kolganovr/KursachKonstruirovanie/Печать/А4 Перечень компонентов.pdf

| | № докум. | Подп. | Дата | МВАУ.405113.008 ПЭ3 Изм. Лист
| | Разраб. | Колганов | | | Датчик температуры | Лит. | Лист | Листов
Пров. | Исаев | | | | | | | 1 4
Н.контр. Инв. № подл. Подп. и дата Взам. инв. № Инв. № дубл. Подп. и дата | Утв. | Исаев Справ. № Перв. примен. МВАУ.40⁵¹¹³.008 | Датчик температуры
BK1 | TO-92 DS18B20 | 1
| Конденсаторы
С1 | ECAP 10x12мм 400В ±20% 1мкФ | 1
С2 | RADIAL-2 9,7х8,3мм 25В ±20% 470мкФ | 1
С3, С4 | 1608 5В ±10% 22мкФ | 2
С5 | 1608 16В ±10% 1мкФ | 1
С6 | RADIAL-2 10,3х11,7мм 16В ±20% 1000мкФ | 1
С7 | 1608 5В ±10% 0,1мкФ | 1

Стабилизатор напряжения

DA1 | SOT-89 78L05 | 1
| Микросхема
DD1 | SOIC-18 PIC16F84A | 1
| Предохранитель плавкий
FU1 | MELF ВП2Т-1Ш 0,25А 250В | 1

Поз.
обозначение
Наименование | Кол. | Примечание
Копировал | Формат A4

## МВАУ.405113.008 ПЭ3 Лист

Излучатель звука электромагнитный

HA1 | KCG0603-K 6,6мм 2-5В 3кГц | 1
| Дисплеи 7-сегментные
HG1..HG3LSD3C52-20 0,32'' 565нм | 3
| Резисторы
R1 | 0805 0,125Вт 20 кОм ±5% | 1
R2 | 0805 0,125Вт 100 Ом ±5% | 1
R3 | 0805 0,125Вт 300 Ом ±5% | 1
R4, R6 | 0805 0,125Вт 2 кОм ±5% | 2
R5 | 0805 0,125Вт 4,7 кОм ±5% | 1
R7 | 0805 0,125Вт 470 Ом ±5% | 1
R8..R14 0805 0,125Вт 200 Ом ±5% | | 7

Кнопки

SB1, SB2 800AWSP9M2QE | | 2
Изм. Лист | № докум. Подп. Дата | | 2 Инв. № подл. Подп. и дата Взам. инв. № Инв. № дубл. Подп. и дата

Диоды

VD1 | КЦ407А 400В 500мА | 1
VD2 | SMB Стабилитрон 15В 3вт ±5% | 1
VD3 | SMA Диод 50в 1А | 1

МВАУ.405113.008 ПЭ3 | Лист
3 Инв. № подл. Подп. и дата Взам. инв. № Инв. № дубл. Подп. и дата | Изм. Лист | № докум. | Подп. | Дата

Транзистор

VT1 | КТ315Б NPN 20В 0,1А 0,15Вт | 1
| Разъем
XS1 | TE_282837-2 5,08мм | 1
| Резонатор кварцевый
Z1 | HC-49SM 4МГц 32пФ | 1

| | № докум. | Подп. | Дата | МВАУ.405113.008 ПЭ3 Изм. Лист
| | Разраб. | Колганов | | | Датчик температуры | Лит. | Лист | Листов
Пров. | Исаев | | | | | | | 4 4
Н.контр. Инв. № подл. Подп. и дата Взам. инв. № Инв. № дубл. Подп. и дата | Утв. | Исаев Справ. № Перв. примен.
| | Лист регистрации изменений
Изм. | Номера листов (страниц) | Всего листов (страниц) в доку-менте | Номер документа | Входящий номер сопроводи-тельного документа и дата | Подпись | Дата
изме-нен-ных | заме-нен-ных | новых анну- | лиро-ван-ных
