kolganovr/KursachKonstruirovanie/Печать/А4 Спецификация платы.pdf

| | № докум. | Подп. | Дата | МВАУ.405113.008 Изм. Лист
| | Разраб. | Колганов | | | Датчик температуры | Лит. | Лист | Листов
Пров. | Исаев | | | | | | | 1 4
Н.контр. Инв. № подл. Подп. и дата Взам. инв. № Инв. № дубл. Подп. и дата | Утв. | Исаев Справ. № Перв. примен. МВАУ.40⁵¹¹³.007 | Документация
А4 | | МВАУ.405113.008 СБ | Сборочный чертёж
А3 | | МВАУ.405113.008 Э3 | Схема электрическая
| | | принципиальная
А4 | | МВАУ.405113.008 ПЭ3 | Перечень элементов
| Поз. 5 | Обозначение | SMA Диод 50в 1А Наименование | Кол. 1 | VD3 Формат Зона Приме-

Детали

1 | МВАУ.758724.007 | Плата печатная | 1
| | Прочие изделия

Датчик температуры

2 | TO-92 DS18B20 | 1 | BK1
| Диоды
3 | КЦ407А 400В 500мА | 1 | VD1
4 | SMB Стабилитрон | 1 | VD2
| 15В 3вт ±5%

чание

Копировал | Формат A4

## МВАУ.405113.008 Лист

Дисплеи 7-сегментные

6 | LSD3C52-20 0,32'' 565нм | 3 | HG1..HG3

Излучатель звука
электромагнитный
7 | KCG0603-K 6,6мм 2-5В 3кГц | 1 | HA1
| Кнопки
8 | 800AWSP9M2QE | 2 | SB1, SB2
| Конденсаторы
| 9 | | ECAP 10x12мм | 1 | С1
| | | 400В ±20% 1мкФ
| 10 | | RADIAL-2 9,7х8,3мм | 1 | С2
| | | 25В ±20% 470мкФ
| 11 | | 1608 5В ±10% 22мкФ | 2 | С3, С4
| 12 | | 1608 16В ±10% 1мкФ | 1 | С5
Изм. Лист | 13 | № докум. Подп. Дата | RADIAL-2 10,3х11,7мм | 1 | 2 Инв. № подл. Подп. и дата Взам. инв. № Инв. № дубл. Подп. и дата С6
| | | 16В ±20% 1000мкФ
| 14 | | 1608 5В ±10% 0,1мкФ | 1 | С7

Микросхема

15 | SOIC-18 PIC16F84A | 1 | DD1 Формат Зона | Поз. | Обозначение | Наименование | Кол. | Приме-

МВАУ.405113.008 | Лист
3 Инв. № подл. Подп. и дата Взам. инв. № Инв. № дубл. Подп. и дата | Изм. Лист | № докум. | Подп. | Дата

Предохранитель плавкий

16 | MELF ВП2Т-1Ш | 1 | FU1
| 0,25А 250В

Разъём

17 | TE_282837-2 5,08мм | 1 | XS1
| Резисторы
18 | 0805 0,125Вт 20 кОм ±5% | 1 | R1
19 | 0805 0,125Вт 100 Ом ±5% | 1 | R2
20 | 0805 0,125Вт 300 Ом ±5% | 1 | R3
21 | 0805 0,125Вт 2 кОм ±5% | 2 | R4, R6
22 | 0805 0,125Вт 4,7 кОм ±5% | 1 | R5
23 | 0805 0,125Вт 470 Ом ±5% | 1 | R7
24 | 0805 0,125Вт 200 Ом ±5% | 7 | R8..R14

Резонатор кварцевый

25 | HC-49SM 4МГц 32пФ | 1 | Z1
| Стабилизатор напряжения
26 | SOT-89 78L05 | 1 | DA1
| Транзистор
27 | КТ315Б NPN 20В 0,1А 0,15Вт | 1 | VT1 Формат Зона | Поз. | Обозначение | Наименование | Кол. | Приме-

| | № докум. | Подп. | Дата | МВАУ.405113.008 Изм. Лист
| | Разраб. | Колганов | | | Датчик температуры | Лит. | Лист | Листов
Пров. | Исаев | | | | | | | 4 4
Н.контр. Инв. № подл. Подп. и дата Взам. инв. № Инв. № дубл. Подп. и дата | Утв. | Исаев Справ. № Перв. примен.
| | Лист регистрации изменений
Изм. | Номера листов (страниц) | Всего листов (страниц) в доку-менте | Номер документа | Входящий номер сопроводи-тельного документа и дата | Подпись | Дата
изме-нен-ных | заме-нен-ных | новых анну- | лиро-ван-ных
