kolganovr/KursachKonstruirovanie/Печать/А4 Спецификация устройства.pdf

| | № докум. | Подп. | Дата | МВАУ.405113.007 Изм. Лист
| | Разраб. | Колганов | | | Датчик температуры | Лит. | Лист | Листов
Пров. | Исаев | | | | | | | | 1
Н.контр. Инв. № подл. Подп. и дата Взам. инв. № Инв. № дубл. Подп. и дата | Утв. | Исаев Справ. № Перв. примен. | Документация
А3 | | МВАУ.405113.007 СБ | Сборочный чертеж
| | | Сборочные единицы
А4 | 1 | МВАУ.405113.008 | Печатный узел | 1
| | | Детали
А4 | 2 | МВАУ.731121.007 | Корпус | 1
А4 | 3 | МВАУ.731151.007 | Крышка | 1

Стандартные изделия

4 | Винт А.М2,5-6gx11 | 4
| ГОСТ 17473-80
5 | Винт А.М2,5-6gx6 | 4
ГОСТ 17473-80 Формат Зона | Поз. | Обозначение | Наименование | Кол. | Приме-
чание
Копировал | Формат A4
