kolganovr/KursachKonstruirovanie/Печать/Титульник.pdf

Москва 2023 г.

Федеральное государственное бюджетное образовательное

учреждение высшего образования

МОСКОВСКИЙ АВИАЦИОННЫЙ ИНСТИТУТ

(Национальный исследовательский университет)

Институт №3 «Системы управления, информатика и электроэнергетика»

Кафедра №307 «Цифровые технологии и информационные системы»

ОТЧЕТ

О выполнении курсовой работы по дисциплине

«Конструирование СИВТ»

Выполнил студент

группы М3О-214Б-21

Подпись:

Колганов Роман

Андреевич

Принял

Ст. преподаватель

Подпись:

Исаев Владимир

Владимирович
