kolganovr/KursachKonstruirovanie/Модель платы/PCB1.step

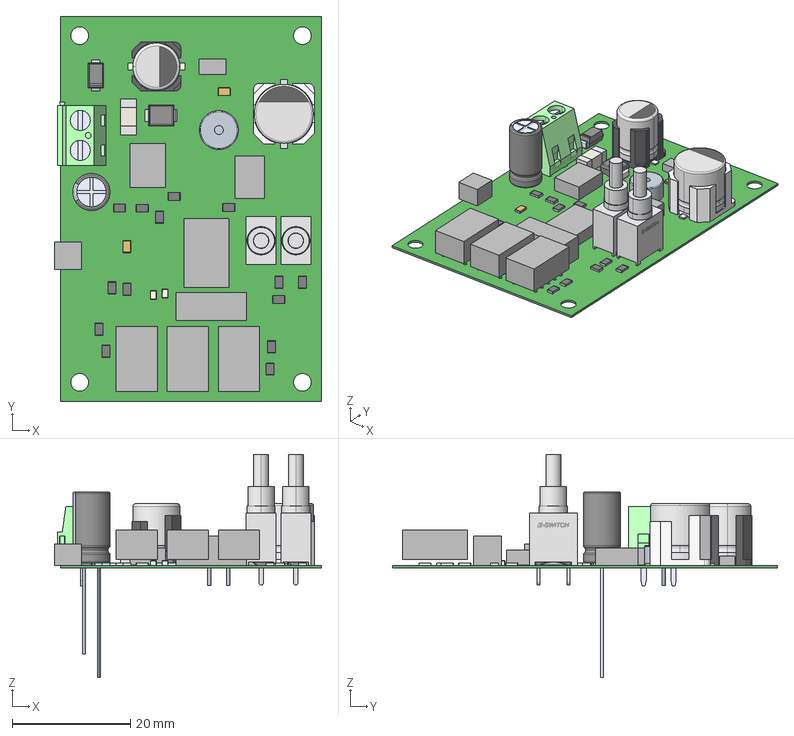
[picture p1: CAD file, 2023-06-10]
Модель платы/PCB1.step
45.3 x 65.2 x 37.8 mm
Extruded x 12
US1A-13-F
SZ1SMB5929BT3G
TACL226M005RTA x 2
UVY2G010MED1TD
Mid Body x 14
Mark x 14
