kolganovr/KursachKonstruirovanie/Печать/А3 Карта отверстий.pdf

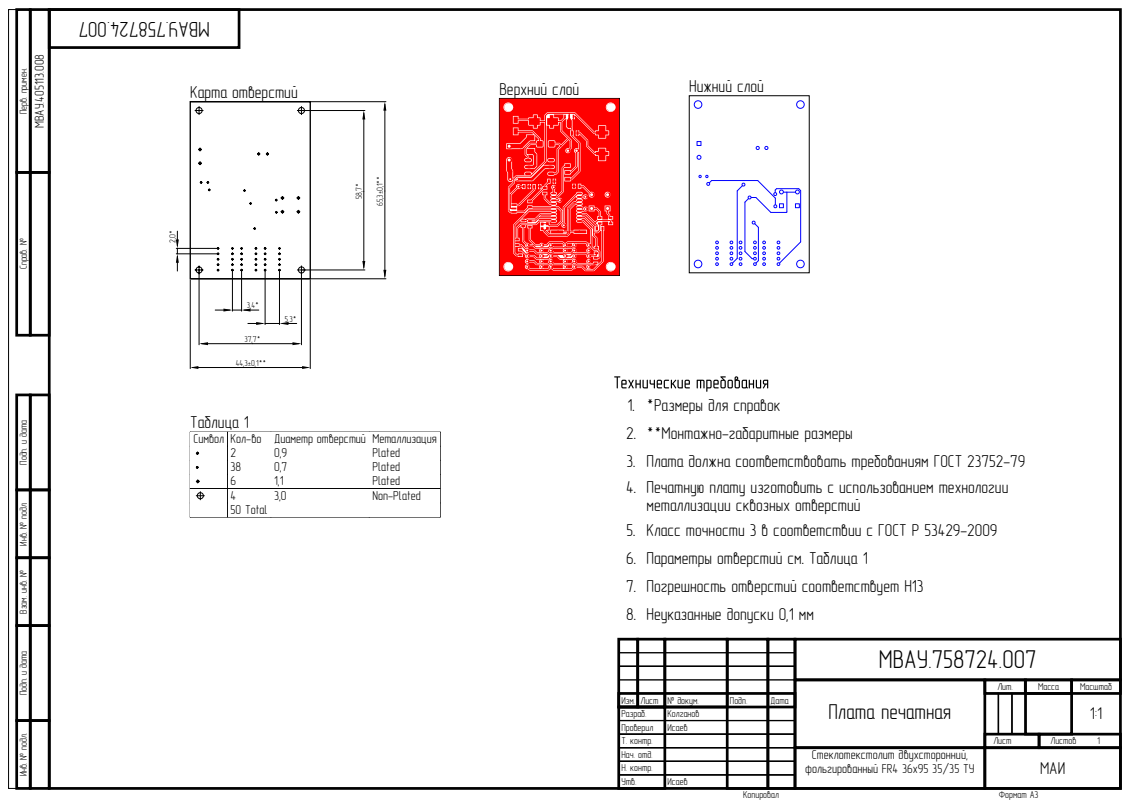
[picture p2: page 1]
Карта отверстий; Верхний слой; Нижний слой; Таблица 1; Изм. Лист № докум. Разраб.; Подп.; Дата; Проверил Т. контр.; Н. контр. Утв.; Лит.; Масса; Масштаб; Лист; Листов; Плата печатная; МВАУ.758724.007; Колганов; Исаев; Копировал; Формат А3; МАИ; Нач. отд.; МВАУ.405113.008; Стеклотекстолит двухсторонний, фольгированный FR4 36x95 35/35 ТУ

Перв. примен. Справ. № Подп. и дата Инв. № подл. Взам. инв. № Подп. и дата Инв. № подл.

1. *Размеры для справок
2. **Монтажно-габаритные размеры
3. Плата должна соответствовать требованиям ГОСТ 23752-79
Печатную плату изготовить с использованием технологии
металлизации сквозных отверстий
5. Класс точности 3 в соответствии с ГОСТ Р 53429-2009
6. Параметры отверстий см. Таблица 1
7. Погрешность отверстий соответствует H13
8. Неуказанные допуски 0,1 мм

Символ | Кол-во | Диаметр отверстий | Металлизация
2 | 0,9 | Plated
38 | 0,7 | Plated
6 | 1,1 | Plated
4 | 3,0 | Non-Plated
50 Total
