kolganovr/KursachKonstruirovanie/Печать/А4 Чертеж Корпус.pdf

А

R4

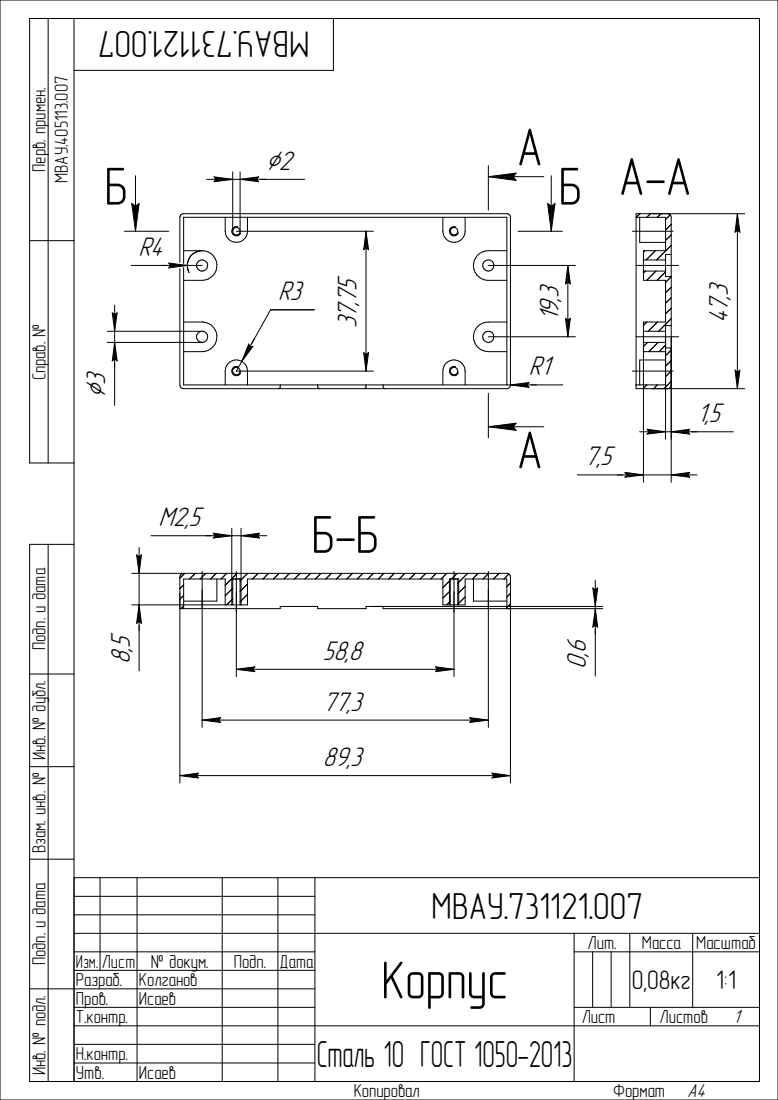
[picture p3: page 1]
Исаев; Сталь 10 ГОСТ 1050-2013 Инв. № подл. Подп. и дата Взам. инв. № Инв. № дубл. Подп. и дата Справ. № Перв. примен.; МВАУ.40⁵¹¹³.007; Копировал; Формат A4

МВАУ.731121.007

Корпус | Лит. | Масса | Масштаб

Изм. Лист | № докум. | Подп. | Дата | | | | | 0,08кг | 1:1
Разраб. | Колганов
Пров. | Исаев
Т.контр. | | | | Лист | Листов 1
Н.контр.
Утв.
