kolganovr/KursachKonstruirovanie/Печать/А4 Чертеж Крышка.pdf

11

R4 | 1,67

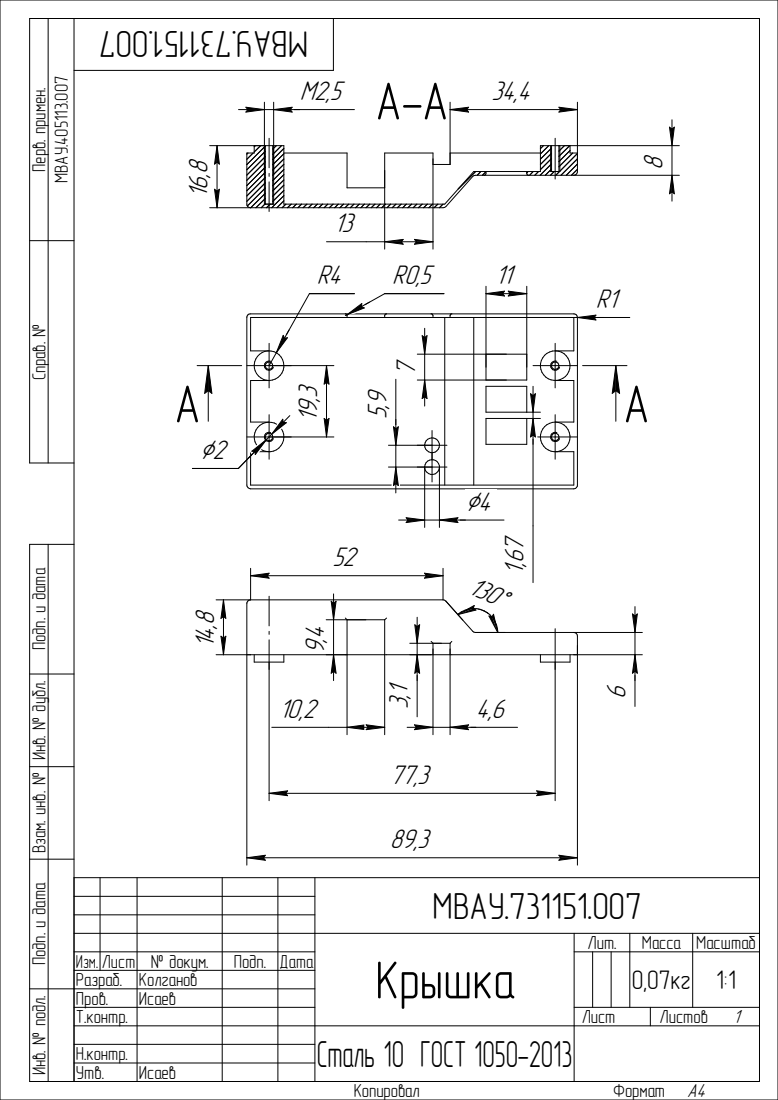
[picture p4: page 1]
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

МВАУ.731151.007

Крышка | Лит. | Масса | Масштаб

Изм. Лист | № докум. | Подп. | Дата | | | | | 0,07кг | 1:1
Разраб. | Колганов
Пров. | Исаев
Т.контр. | | | | Лист | Листов 1
Н.контр.
Утв.
