kolganovr/KursachKonstruirovanie/Печать/А3 Принципиальная схема.pdf

*ST

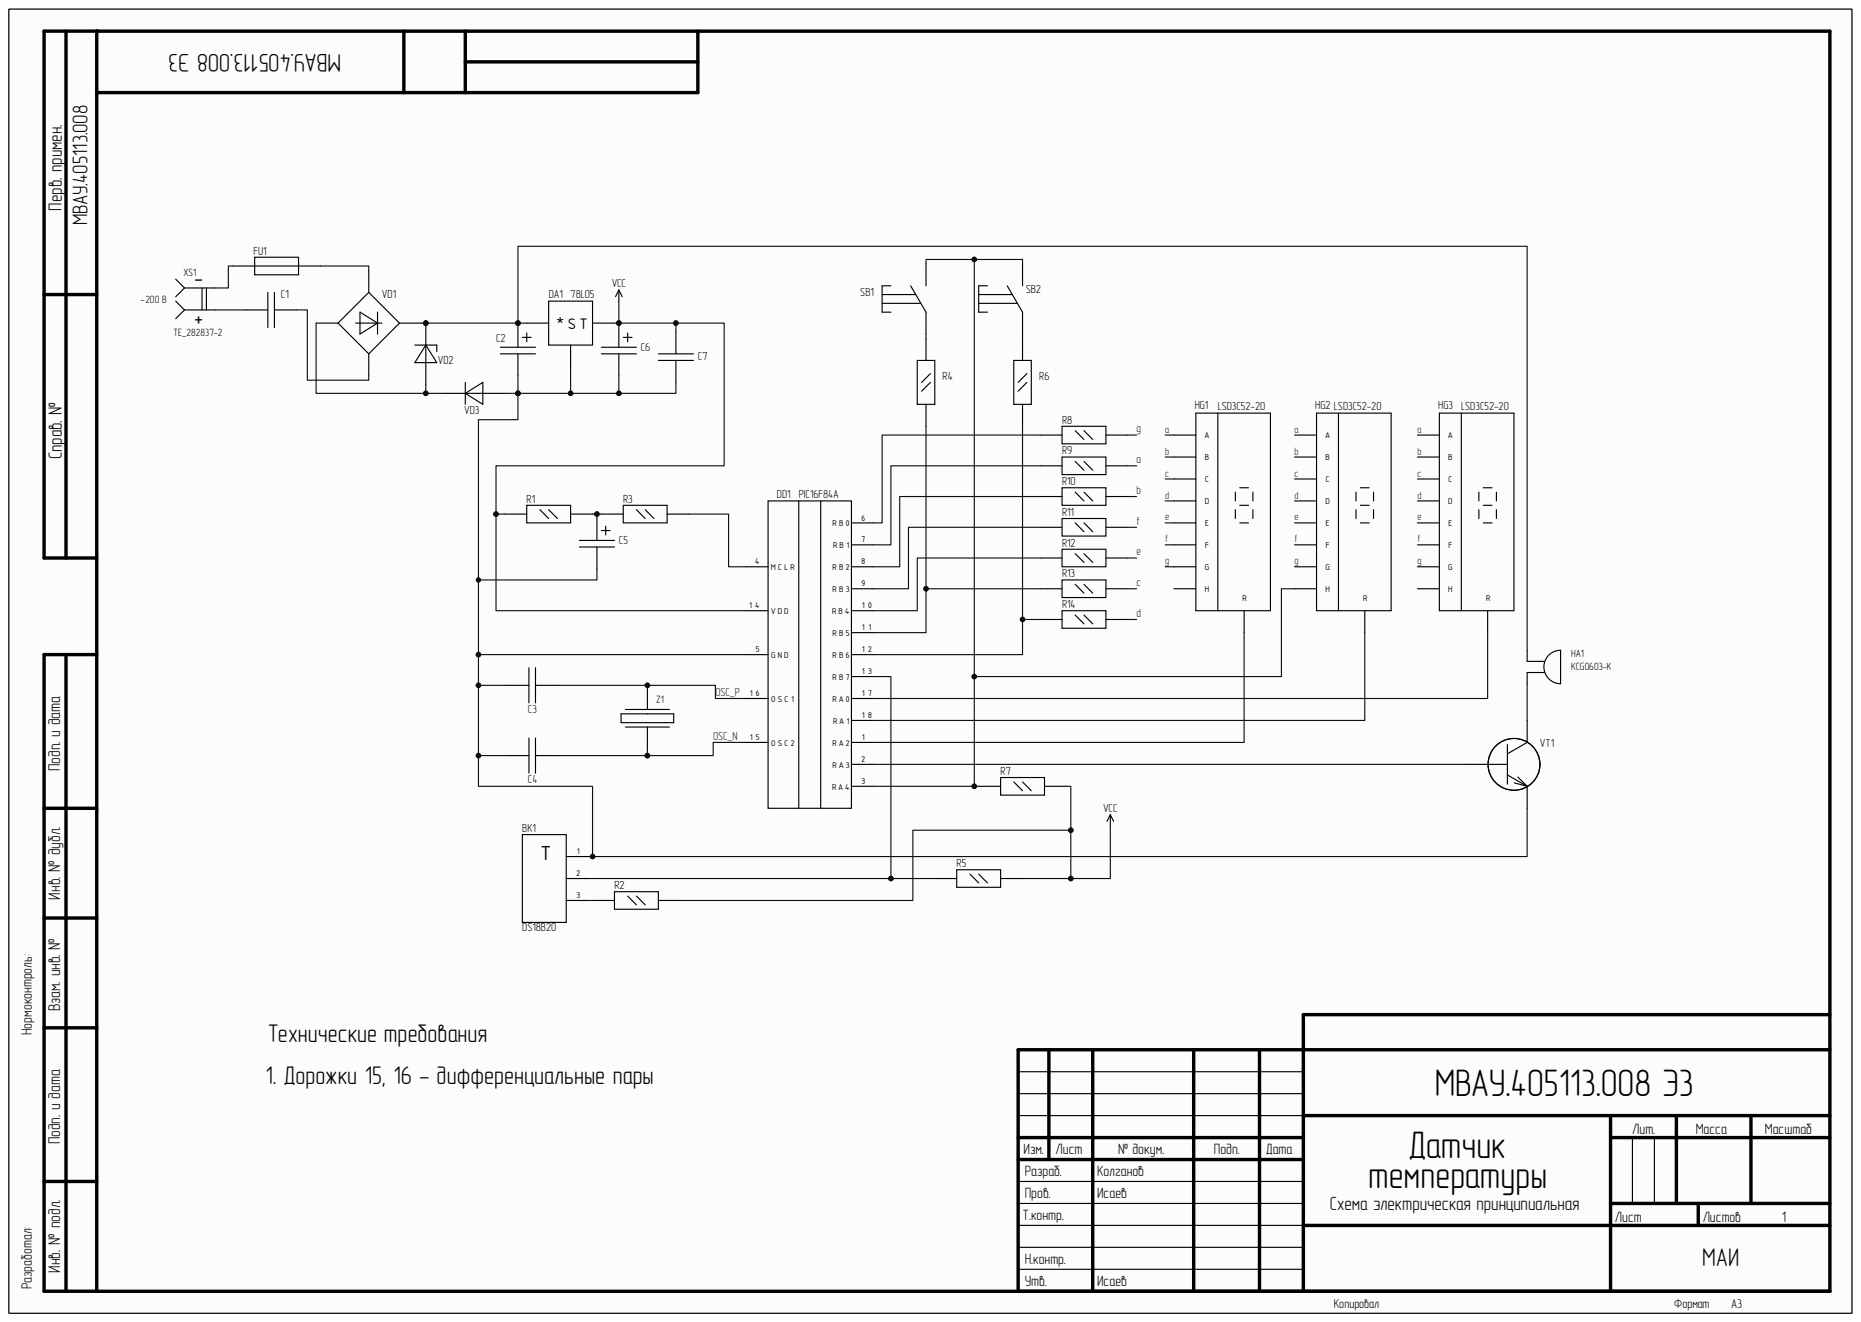
[picture p5: page 1]

МВАУ.405113.008 Э3

Датчик температуры Схема электрическая принципиальная | Лит. | Масса | Масштаб

Изм. | Лист | № докум. | Подп. | Дата
Разраб. | | Колганов
Пров. | | Исаев
Т.контр. | | | | | Лист | Листов 1

МАИ

Н.контр.
Утв. | Исаев
