kolganovr/KursachKonstruirovanie/Печать/А3 Чертеж Устройства.pdf

Б

А

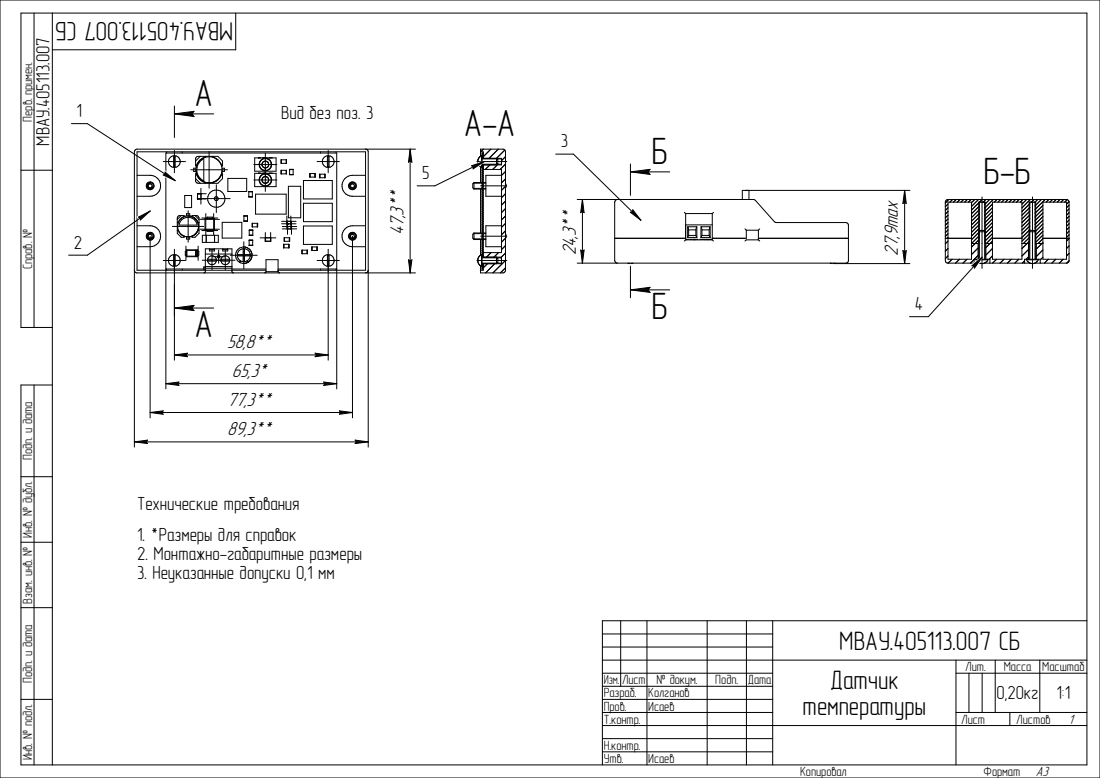
[picture p6: page 1]
27,9max; 0,20кг Датчик; Исаев Инв. № подл. Подп. и дата Взам. инв. № Инв. № дубл. Подп. и дата; Исаев Справ. № Перв. примен. МВАУ.40⁵¹¹³.007; Копировал; Формат A3

Вид без поз. 3

Технические требования
1. *Размеры для справок
2. Монтажно-габаритные размеры
3. Неуказанные допуски 0,1 мм

МВАУ.405113.007 СБ

температуры | Лит. | Масса | Масштаб

Изм. Лист | № докум. | Подп. | Дата | | | | | 1:1
Разраб. | Колганов
Пров.
Т.контр. | | | | Лист | Листов 1
Н.контр.
Утв.
