kolganovr/KursachKonstruirovanie/Печать/А4 Плата СБ.pdf

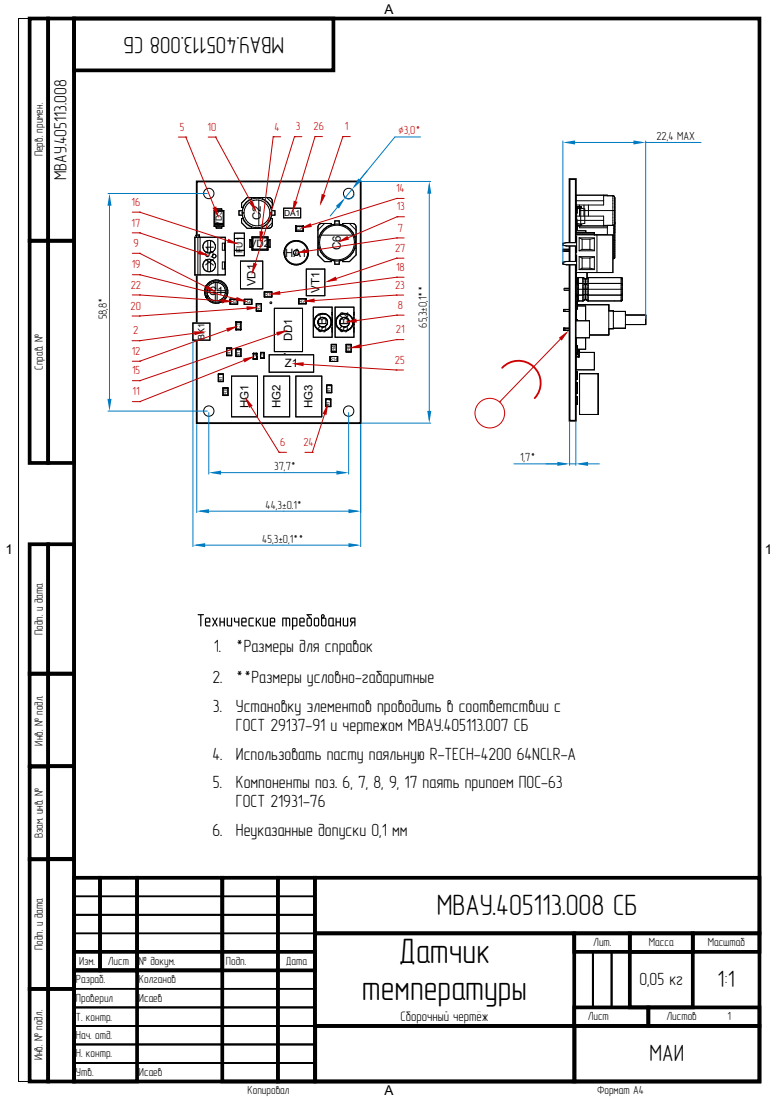
[picture p7: page 1]

Перв. примен. Справ. № Подп. и дата Инв. № подл. Взам. инв. № Подп. и дата Инв. № подл.

1. *Размеры для справок
2. **Размеры условно-габаритные
Установку элементов проводить в соответствии с
ГОСТ 29137-91 и чертежом МВАУ.405113.007 СБ
4. Использовать пасту паяльную R-TECH-4200 64NCLR-A
Компоненты поз. 6, 7, 8, 9, 17 паять припоем ПОС-63
ГОСТ 21931-76
6. Неуказанные допуски 0,1 мм
