kolganovr/KursachKonstruirovanie/(list of files, drawings)

Other design files:
PCB1.PcbDoc
PCB_Project_2.PrjPcb
PcbLib_RomanK.PcbLib
RomanK1.SchDoc
RomanK.SchDoc
RomanK.SchLib
