kolganovr/KursachKonstruirovanie/(commit log)

2023-05-26 public repositorium
    [PCB_Project_2.PrjPcb, PcbLib_RomanK.PcbLib, RomanK.SchDoc, RomanK.SchLib, RomanK1.SchDoc]
2023-05-28 Add КД243А
    [PcbLib_RomanK.PcbLib]
2023-05-28 Add КЦ407А
    +rename PIC 16
    [PcbLib_RomanK.PcbLib]
2023-05-28 Button 2 pin
    [PcbLib_RomanK.PcbLib]
2023-05-28 КТ315Б
    [PcbLib_RomanK.PcbLib]
2023-05-28 ds18b20 (Temp)
    [PcbLib_RomanK.PcbLib]
2023-05-28 ВП2Т-1Ш (плавкий предохранитель)
    [PcbLib_RomanK.PcbLib]
2023-05-28 lsd3212-20 (7 segment display)
    [PcbLib_RomanK.PcbLib]
2023-05-28 HC0903A (Пищалка)
    [PcbLib_RomanK.PcbLib]
2023-05-29 Screw terminal
    not sure
    [PcbLib_RomanK.PcbLib]
2023-05-29 add footprints (not all) and create pcb
    [PCB1.PcbDoc, RomanK.SchLib]
2023-05-29 update font in schematics
    +fix PIC footprint on led
    [RomanK.SchLib]
2023-05-29 res scheme fix
    [RomanK.SchLib]
2023-05-29 add polar capasitor
    [PcbLib_RomanK.PcbLib]
2023-05-29 add footprints of capasitors to Sch Lib
    [RomanK.SchLib]
2023-05-29 Много чего-то
    [PCB1.PcbDoc, PcbLib_RomanK.PcbLib, RomanK.SchLib, RomanK1.SchDoc]
2023-05-29 Fuse box
    [RomanK.SchLib]
2023-05-30 update designators
    new lsd
    [PCB1.PcbDoc, PCB_Project_2.PrjPcb, PcbLib_RomanK.PcbLib, RomanK.SchLib, RomanK1.SchDoc]
2023-05-30 3x lsd some tweaks
    [PCB1.PcbDoc, PcbLib_RomanK.PcbLib, RomanK.SchLib, RomanK1.SchDoc]
2023-06-01 update schdoc
    [PCB1.PcbDoc, RomanK1.SchDoc]
2023-06-01 fix board issue. Start making board
    [PcbLib_RomanK.PcbLib, RomanK.SchLib, RomanK1.SchDoc]
2023-06-01 before 2 layers
    [PCB1.PcbDoc]
2023-06-01 no poligon
    [PCB1.PcbDoc]
2023-06-02 final pcb (i guess)
    [PCB1.PcbDoc, PcbLib_RomanK.PcbLib, RomanK1.SchDoc]
2023-06-04 new elemets + compact
    [PCB1.PcbDoc, PcbLib_RomanK.PcbLib, RomanK.SchLib, RomanK1.SchDoc]
2023-06-05 some fix and holes
    [PCB1.PcbDoc, PCB_Project_2.PrjPcb]
2023-06-05 new fuse box
    [PCB1.PcbDoc, PcbLib_RomanK.PcbLib, RomanK.SchLib, RomanK1.SchDoc]
2023-06-05 scheme list update
    [PCB1.PcbDoc, RomanK1.SchDoc]
2023-06-05 update scheme
    [RomanK1.SchDoc]
2023-06-05 updatet text in scheme
    [PcbLib_RomanK.PcbLib, RomanK1.SchDoc]
2023-06-05 fix list template
    [RomanK1.SchDoc]
2023-06-05 update buzzer footprint
    [PCB1.PcbDoc, PcbLib_RomanK.PcbLib]
2023-06-06 roads fix
    [PCB1.PcbDoc]
2023-06-06 new buttons
    [PCB1.PcbDoc, PcbLib_RomanK.PcbLib, RomanK.SchLib, RomanK1.SchDoc]
2023-06-06 big polygone + update footprint button
    [PCB1.PcbDoc, PcbLib_RomanK.PcbLib, RomanK1.SchDoc]
2023-06-06 replace pads 7 segment
    [PCB1.PcbDoc, PcbLib_RomanK.PcbLib]
2023-06-06 new path for 7 segmet dot
    [PCB1.PcbDoc]
2023-06-06 new c1
    [PcbLib_RomanK.PcbLib, RomanK.SchLib, RomanK1.SchDoc]
2023-06-06 all capasitors
    [PCB1.PcbDoc, PcbLib_RomanK.PcbLib, RomanK.SchLib, RomanK1.SchDoc]
2023-06-06 all capasitors now
    [PCB1.PcbDoc, PcbLib_RomanK.PcbLib, RomanK.SchLib, RomanK1.SchDoc]
2023-06-06 update pcb
    [PCB1.PcbDoc, PcbLib_RomanK.PcbLib, RomanK.SchLib, RomanK1.SchDoc]
2023-06-06 power update
    and i dont know what else....
    [PCB1.PcbDoc, PcbLib_RomanK.PcbLib, RomanK.SchLib, RomanK1.SchDoc]
2023-06-06 Перечень вроде есть хочу спать помогите
2023-06-06 shrink pcb
    [PCB1.PcbDoc]
2023-06-06 fix screws
    [PCB1.PcbDoc]
2023-06-06 спецификация платы + fix holes
    [PCB1.PcbDoc]
2023-06-07 спецификация устройства + новый шаблон
    [RomanK1.SchDoc]
2023-06-07 drill drawing
    [PCB1.PcbDoc, PcbLib_RomanK.PcbLib, RomanK1.SchDoc]
2023-06-07 Сборочный чертёж
    полетел текст сбоку
2023-06-07 fonts update in scheme
    [RomanK1.SchDoc]
2023-06-07 update qarz
    [PcbLib_RomanK.PcbLib, RomanK.SchLib, RomanK1.SchDoc]
2023-06-07 я хз что
    [PCB1.PcbDoc, PCB_Project_2.PrjPcb]
2023-06-07 спецификация платы и обновл принцип
    [RomanK1.SchDoc]
2023-06-07 плата сборочный чертеж
2023-06-08 много чего
    [PCB1.PcbDoc, PCB_Project_2.PrjPcb]
2023-06-09 чет дофига
    [PCB1.PcbDoc, PCB1.step, RomanK1.SchDoc]
2023-06-10 подготовка к корпусу
    [PCB1.PcbDoc, PCB1.step, PcbLib_RomanK.PcbLib, RomanK.SchLib, RomanK1.SchDoc]
2023-06-10 Корпус + начало чертежа и спецификации
2023-06-18 +- final
    [PCB1.PcbDoc, PCB_Project_2.PrjPcb, PcbLib_RomanK.PcbLib, RomanK.SchLib, RomanK1.SchDoc]
2023-06-18 add material
